GadgetReboot/SD_Tape_Player/README.md

# SD_Tape_Player
Play computer cassette data audio files from a micro SD card with Arduino Nano<BR><BR>
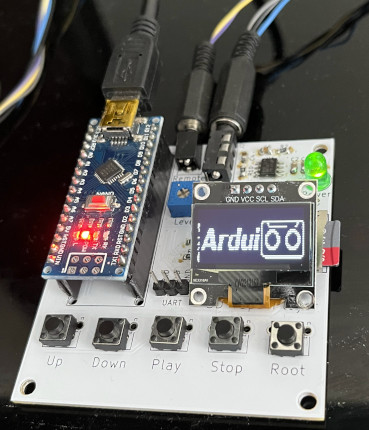
[picture p1: Assembled_PCB.jpg]
pcb
<br><br>
This pcb was tested with the Arduino sketch for CASDuino 1.24 obtained here http://arduitape.blogspot.com/2020/08/new-castzxduino-firmware.html
