GadgetReboot/SD_Tape_Player/SD_Tape_Player-sch.pdf

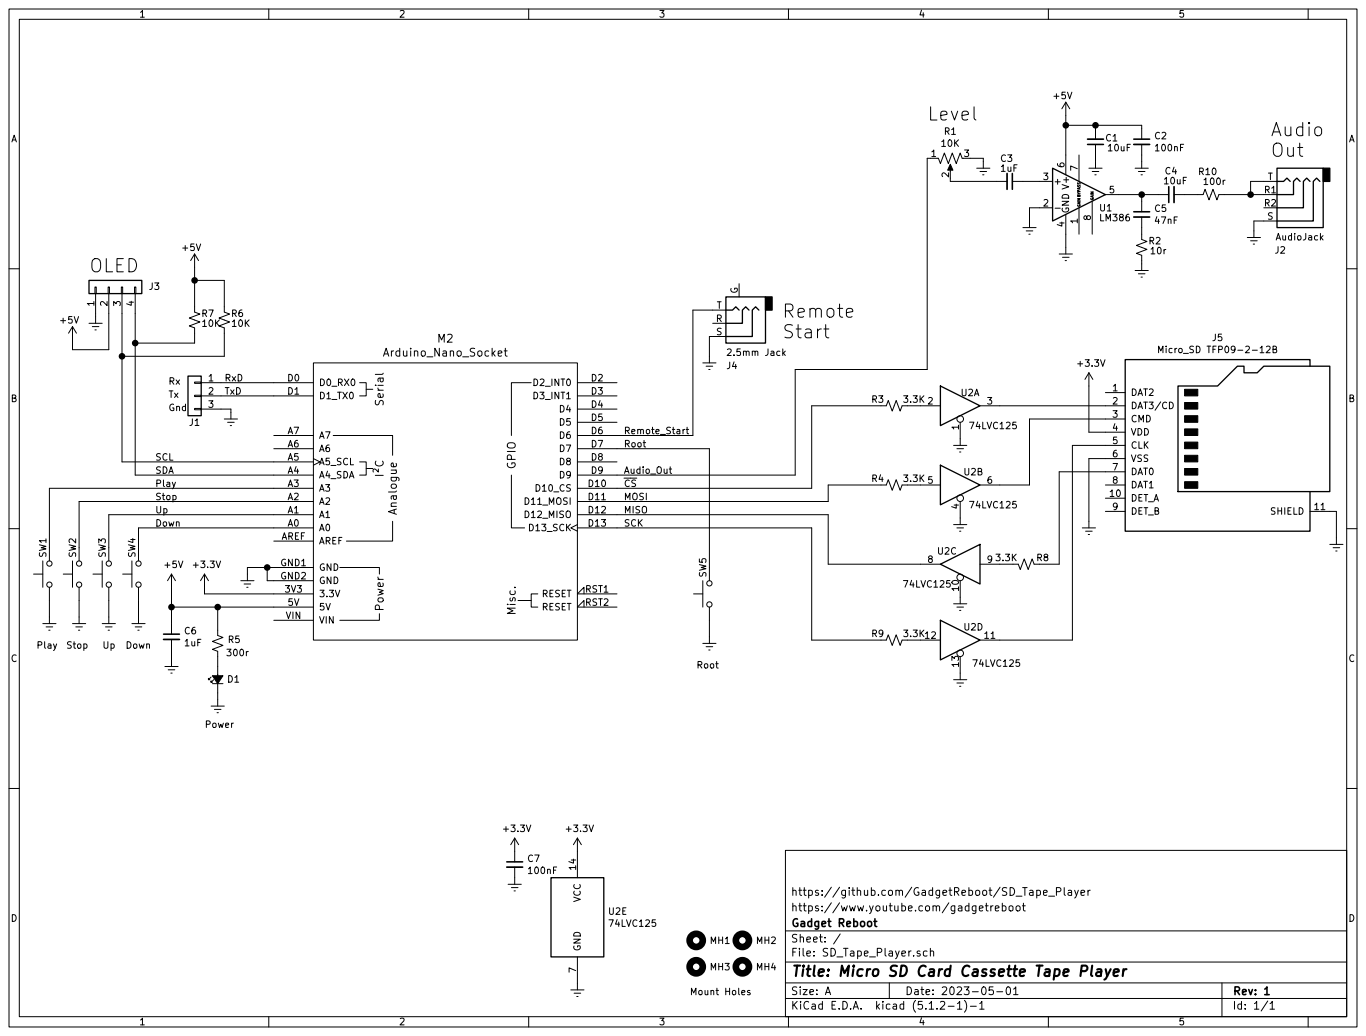
[picture p2: page 1]

https://www.youtube.com/gadgetreboot
File: SD_Tape_Player.sch Sheet: / Gadget Reboot

Id: 1/1 Title: Micro SD Card Cassette Tape Player
