GadgetReboot/SD_Tape_Player/KiCad/SD_Tape_Player.kicad_pcb

## KiCad design KiCad/SD_Tape_Player.kicad_pcb (2023-05-01)

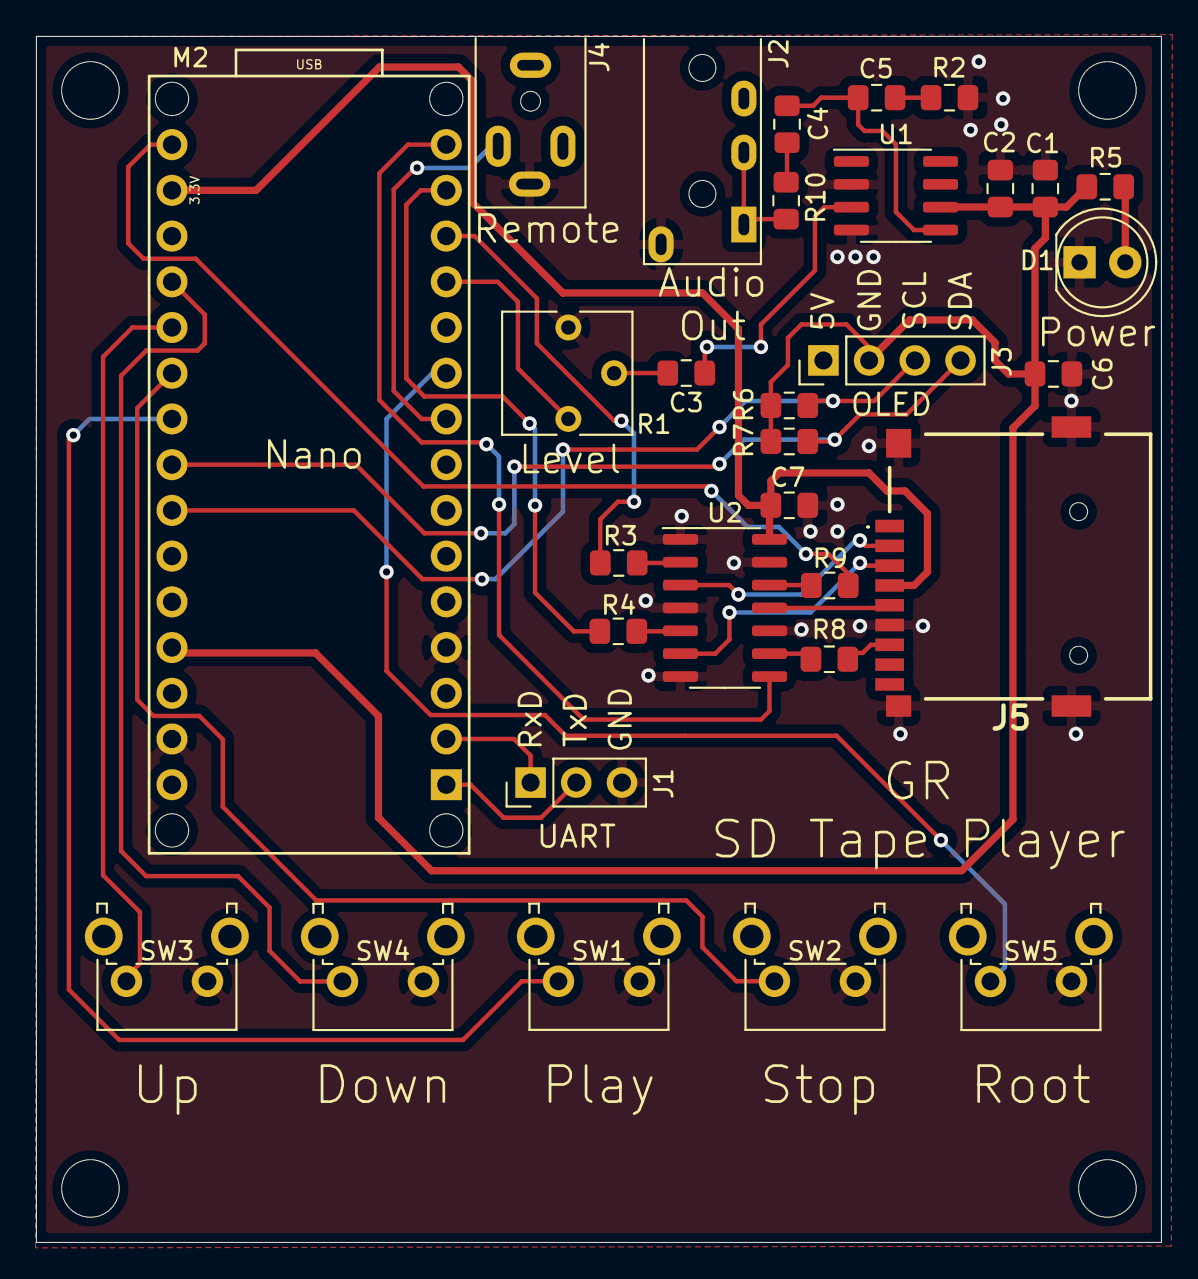
[picture p3: board SD_Tape_Player.kicad_pcb from above]

Board: 2 copper layers, 62.5 x 67.0 mm, 35 parts (0 on the bottom side), 33 nets.

Parts:
C1, C4: 10uF; C_0805_2012Metric_Pad1.15x1.40mm_HandSolder
C2, C7: 100nF; C_0805_2012Metric_Pad1.15x1.40mm_HandSolder
C3, C6: 1uF; C_0805_2012Metric_Pad1.15x1.40mm_HandSolder
C5: 47nF; C_0805_2012Metric_Pad1.15x1.40mm_HandSolder
D1: LED_Small_ALT; LED_D5.0mm
J1: UART; PinHeader_1x03_P2.54mm_Vertical
J2: AudioJack; Jack_3.5mm_PJ320A_Horizontal
J3: Conn_01x04; PinHeader_1x04_P2.54mm_Vertical
J4: 2.5mm Jack; Jack_2.5mm_PJ210B
J5: Micro_SD TFP09-2-12B; TFP09212B
M2: Arduino_Nano_Socket
MH1, MH2, MH3, MH4: MountingHole; MountingHole_3.2mm_M3
R1: 10K; Potentiometer_Vishay_T73YP_Vertical
R2: 10r; R_0805_2012Metric_Pad1.15x1.40mm_HandSolder
R3, R4, R5, R8, R9: 3.3K; R_0805_2012Metric_Pad1.15x1.40mm_HandSolder
R6, R7: 10K; R_0805_2012Metric_Pad1.15x1.40mm_HandSolder
R10: 100r; R_0805_2012Metric_Pad1.15x1.40mm_HandSolder
SW1, SW2, SW3, SW4, SW5: B3F-3100; SW_Tactile_SPST_Angled_PTS645Vx31-2LFS
U1: LM386; SOIC-8_3.9x4.9mm_P1.27mm
U2: 74LVC125; SOIC-14_3.9x8.7mm_P1.27mm

Connections:
+3V3: C7.1, J5.4, M2.3V3, U2.14
+5V: C1.2, C2.1, C6.1, J3.2, M2.5V, R5.2, R6.1, R7.1, U1.6
/Audio_Out: M2.D9, R1.1
/Down: M2.A0, SW4.2
/MISO: M2.D12, U2.8
/MOSI: M2.D11, R4.2
/Play: M2.A3, SW1.2
/Remote_Start: J4.T, M2.D6
/Root: M2.D7, SW5.2
/RxD: J1.1, M2.D0
/SCK: M2.D13, R9.2
/SCL: J3.3, M2.A5, R6.2
/SDA: J3.4, M2.A4, R7.2
/Stop: M2.A2, SW2.2
/TxD: J1.2, M2.D1
/Up: M2.A1, SW3.2
/~CS: M2.D10, R3.2
GNDREF: C1.1, C2.2, C6.2, C7.2, D1.1, J1.3, J2.S, J3.1, J4.S, J5.6, J5.11, M2.GND1, M2.GND2, R1.3, R2.2, SW1.1, SW2.1, SW3.1, SW4.1, SW5.1, U1.2, U1.4, U2.1, U2.4, U2.7, U2.10, U2.13
unnamed: C3.1, U1.3
unnamed: C3.2, R1.2
unnamed: C4.1, C5.1, U1.5
unnamed: C4.2, R10.2
unnamed: C5.2, R2.1
unnamed: D1.2, R5.1
unnamed: J2.R1, J2.T, R10.1
unnamed: J5.2, U2.3
unnamed: J5.3, U2.6
unnamed: J5.5, U2.11
unnamed: J5.7, R8.2
unnamed: R3.1, U2.2
unnamed: R4.1, U2.5
unnamed: R8.1, U2.9
unnamed: R9.1, U2.12
